OLIMEX/ESP32-PRO/README.md

# ESP32-PRO
Open-source hardware ESP32 IoT board with 4MB external RAM, 4MB external flash, LiPo charger, USB-OTG, external crypto engine option. The board uses PIC32 as USB-serial converter. 

Product page:

https://www.olimex.com/Products/IoT/ESP32/ESP32-PRO/open-source-hardware
