OLIMEX/ESP32-PRO/SOFTWARE/ESP32_part_Arduino_IDE/ESP32_Demo/README.txt

This example works with Espressif package 1.0.0v. With 1.0.1v compiling fails.
