OLIMEX/ESP32-PRO/HARDWARE/REV-B1/3d/usb_micro_4p.stp

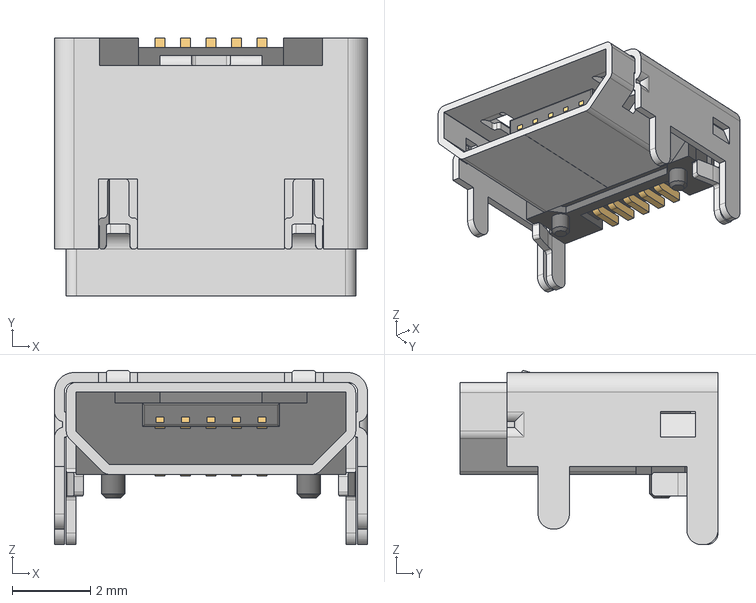
[picture p1: CAD file, 2020-09-01]
HARDWARE/REV-B1/3d/usb_micro_4p.stp
8.00 x 6.60 x 4.46 mm
