OLIMEX/ESP32-PRO/HARDWARE/REV-B1/3d/L-CD32_shielded.step

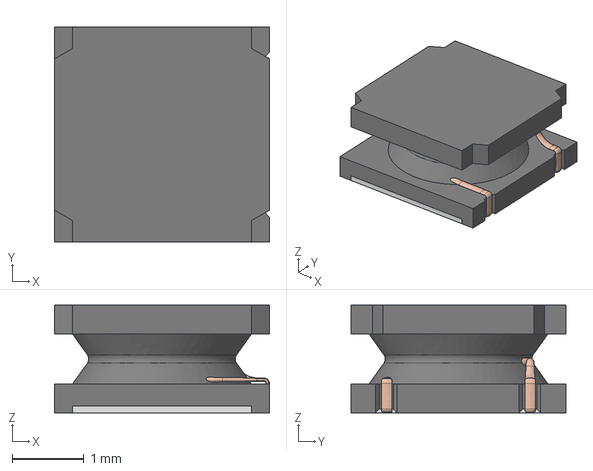
[picture p2: CAD file, 2020-09-01]
HARDWARE/REV-B1/3d/L-CD32_shielded.step
3.00 x 3.00 x 1.50 mm
