OLIMEX/ESP32-PRO/HARDWARE/REV-B1/3d/MSOP10-1.step

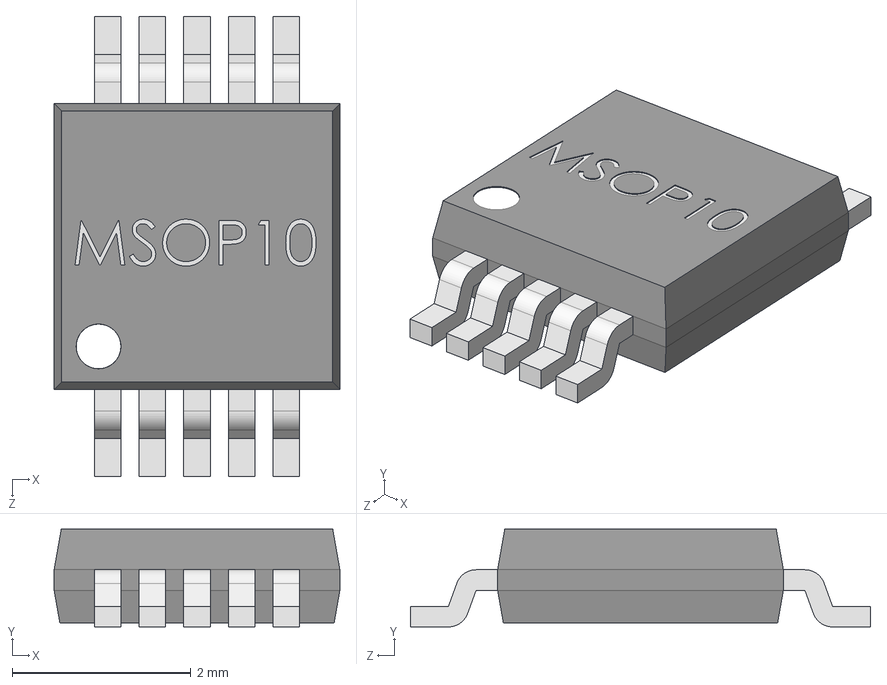
[picture p3: CAD file, 2020-09-01]
HARDWARE/REV-B1/3d/MSOP10-1.step
3.20 x 1.10 x 5.15 mm
