OLIMEX/ESP32-PRO/HARDWARE/REV-B1/3d/TQFP-44-10x10x1mm_Step-0.80mm.STEP

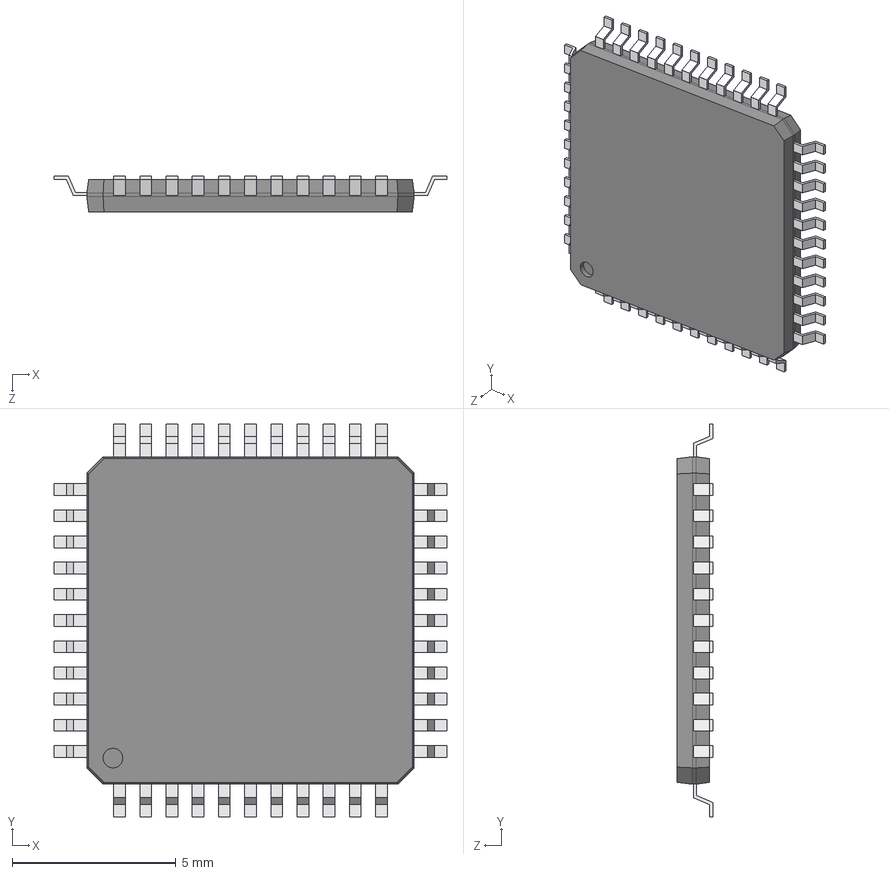
[picture p4: CAD file, 2020-09-01]
HARDWARE/REV-B1/3d/TQFP-44-10x10x1mm_Step-0.80mm.STEP
12.0 x 12.0 x 1.10 mm
pin001
pin021
pin022
pin020
pin019
pin018
pin017
pin024
pin023
pin007
pin003
pin015
pin014
pin013
pin012
pin011
pin010
pin009
pin008
pin006
pin005
pin004
pin002
pin016
pin027
pin037
pin025
pin026
pin036
pin035
pin034
pin033
pin032
pin031
pin030
pin029
pin028
pin038
pin044
pin043
pin042
pin041
pin040
pin039
