OLIMEX/ESP32-PRO/HARDWARE/REV-B1/3d/microSD.step

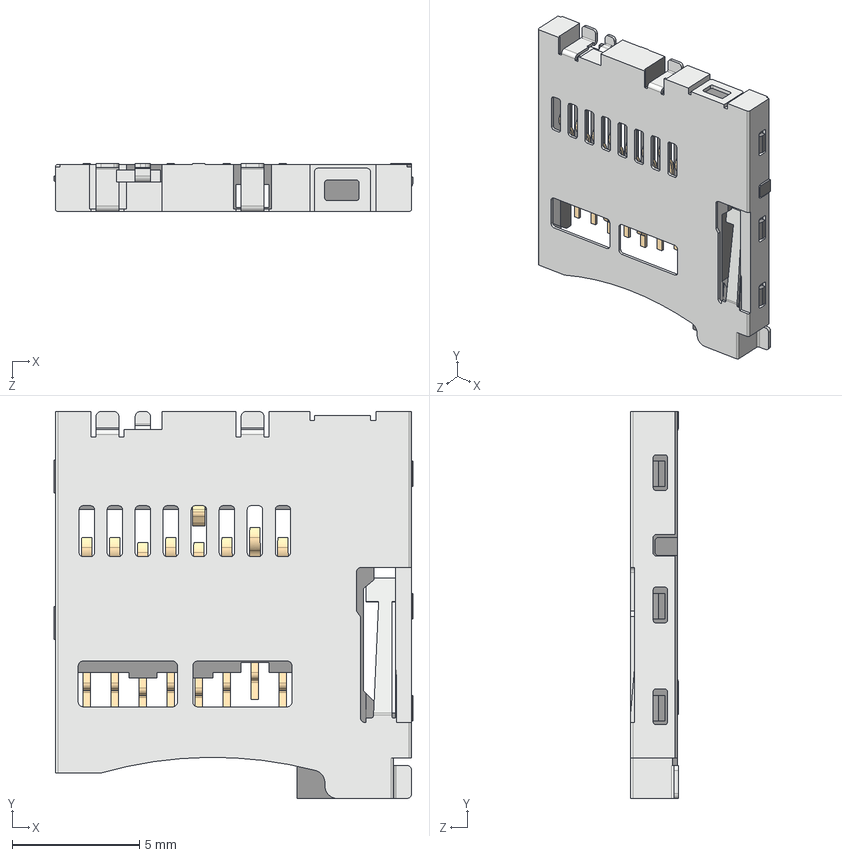
[picture p5: CAD file, 2020-09-01]
HARDWARE/REV-B1/3d/microSD.step
14.1 x 15.2 x 1.88 mm
