OLIMEX/ESP32-PRO/HARDWARE/REV-B1/3d/SO-8_208mil---SOIC8_Wide_5mmx5mm.step

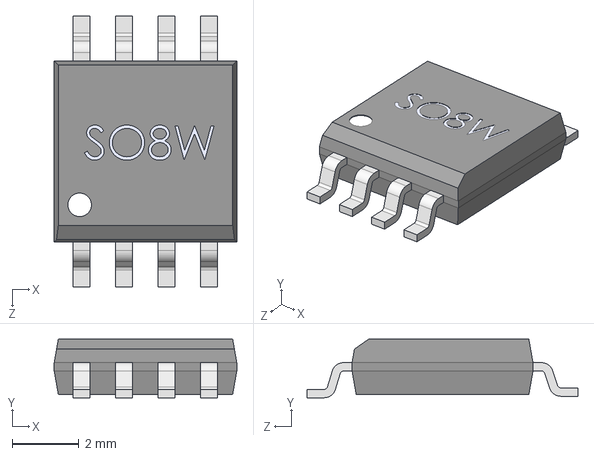
[picture p6: CAD file, 2020-09-01]
HARDWARE/REV-B1/3d/SO-8_208mil---SOIC8_Wide_5mmx5mm.step
5.46 x 1.75 x 8.10 mm
