OLIMEX/ESP32-PRO/HARDWARE/REV-B1/3d/QSG5032.step

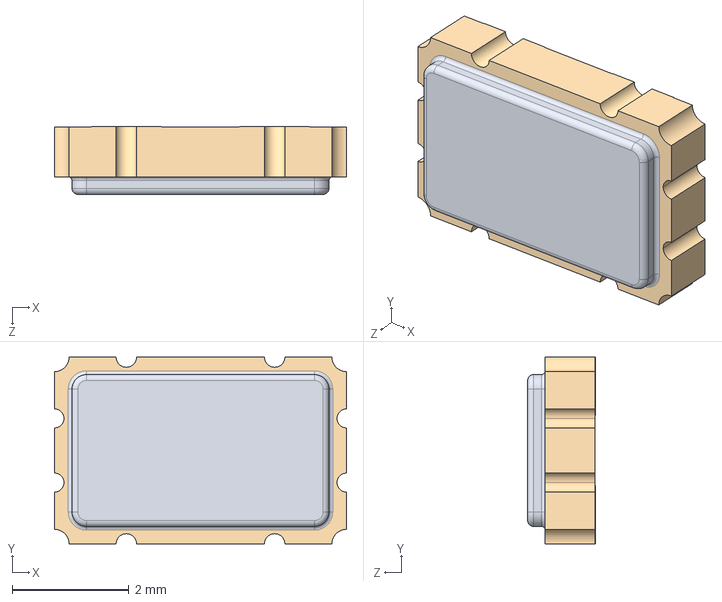
[picture p7: CAD file, 2020-09-01]
HARDWARE/REV-B1/3d/QSG5032.step
5.00 x 3.20 x 1.16 mm
