OLIMEX/ESP32-PRO/HARDWARE/REV-B1/3d/mc-306crystal.step

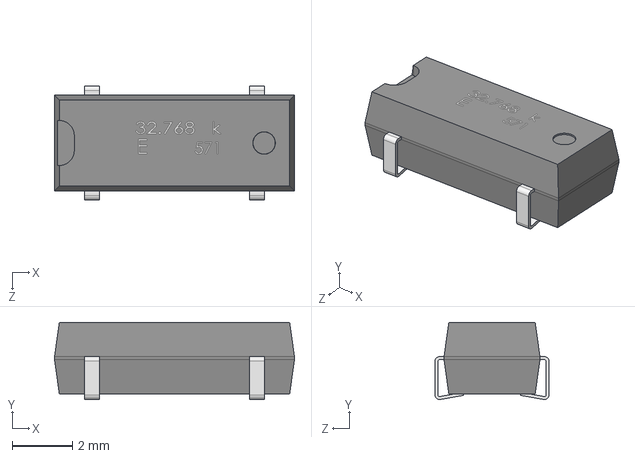
[picture p8: CAD file, 2020-09-01]
HARDWARE/REV-B1/3d/mc-306crystal.step
8.00 x 2.57 x 3.80 mm
