OLIMEX/ESP32-PRO/HARDWARE/REV-B1/3d/BAT54.step

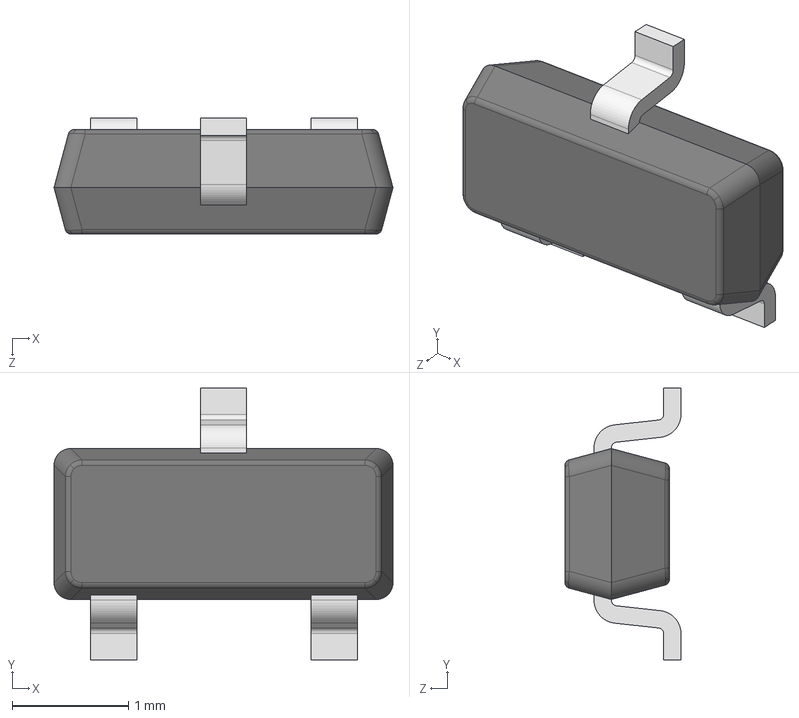
[picture p9: CAD file, 2020-09-01]
HARDWARE/REV-B1/3d/BAT54.step
2.92 x 2.34 x 1.00 mm
