OLIMEX/ESP32-PRO/HARDWARE/REV-B1/3d/Micro_SD_card.step

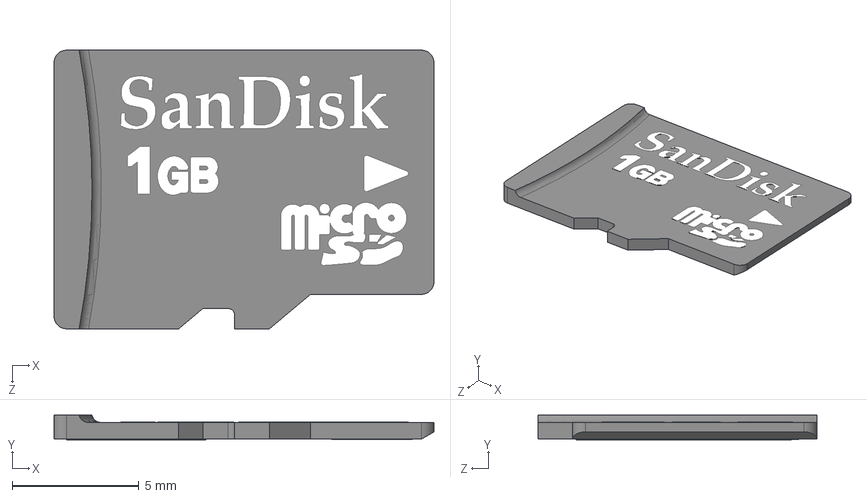
[picture p10: CAD file, 2020-09-01]
HARDWARE/REV-B1/3d/Micro_SD_card.step
15.0 x 0.975 x 11.0 mm
