OLIMEX/ESP32-PRO/HARDWARE/REV-B1/3d/SOT-23.step

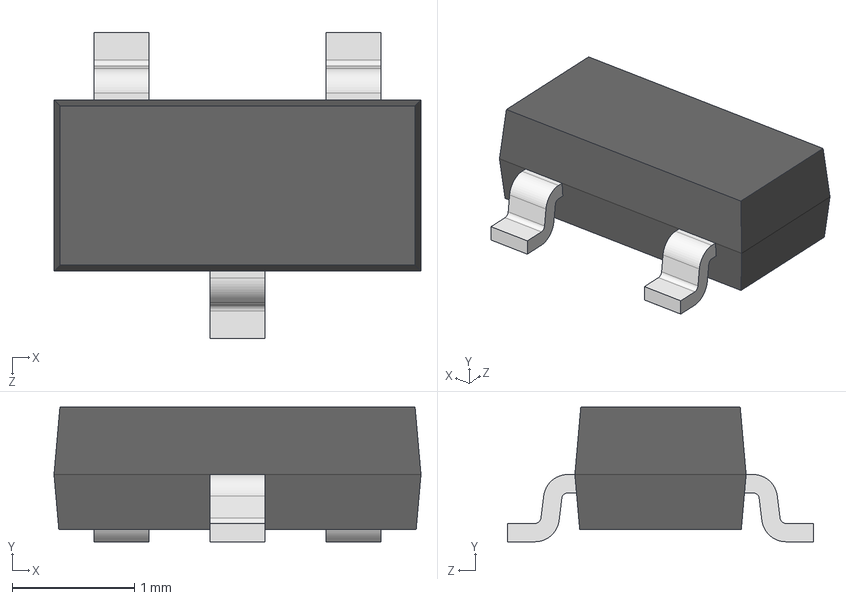
[picture p12: CAD file, 2020-09-01]
HARDWARE/REV-B1/3d/SOT-23.step
3.00 x 1.10 x 2.50 mm
