OLIMEX/ESP32-PRO/HARDWARE/REV-B1/3d/SMD5032.STEP

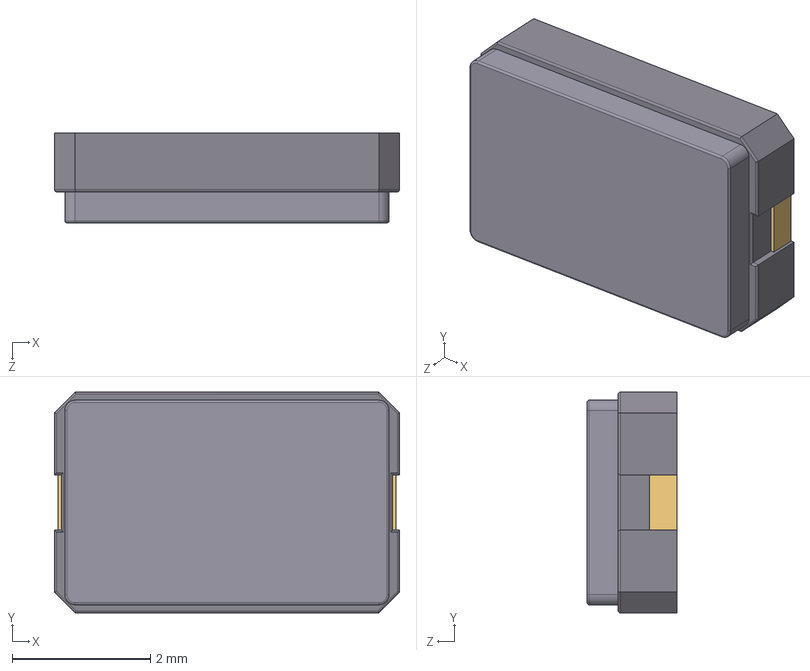
[picture p13: CAD file, 2020-09-01]
HARDWARE/REV-B1/3d/SMD5032.STEP
5.00 x 3.20 x 1.30 mm
User Library-ABM3-1_Fillet002
User Library-ABM3-1_Fillet001
User Library-ABM3-1_Pad001
