OLIMEX/ESP32-PRO/HARDWARE/REV-B1/3d/DO-214AA_SMB.step

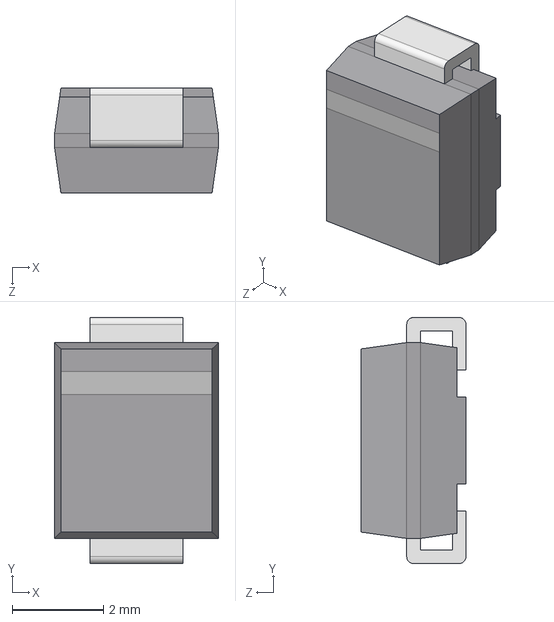
[picture p14: CAD file, 2020-09-01]
HARDWARE/REV-B1/3d/DO-214AA_SMB.step
3.60 x 5.40 x 2.30 mm
