OLIMEX/ESP32-PRO/HARDWARE/REV-B1/3d/JST_B2B-PH-SM4-TB(DW02R).step

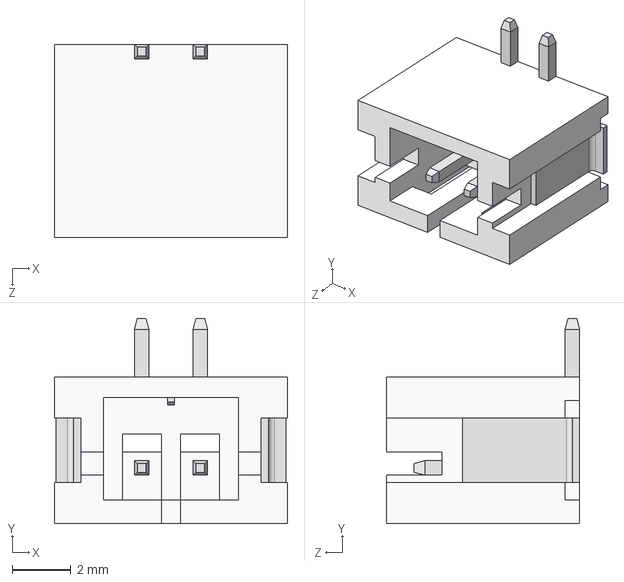
[picture p15: CAD file, 2020-09-01]
HARDWARE/REV-B1/3d/JST_B2B-PH-SM4-TB(DW02R).step
7.95 x 7.00 x 6.60 mm
