OLIMEX/ESP32-PRO/HARDWARE/REV-B1/3d/SO-8_150mil---SN65HVDA1050AQDRQ1.STEP

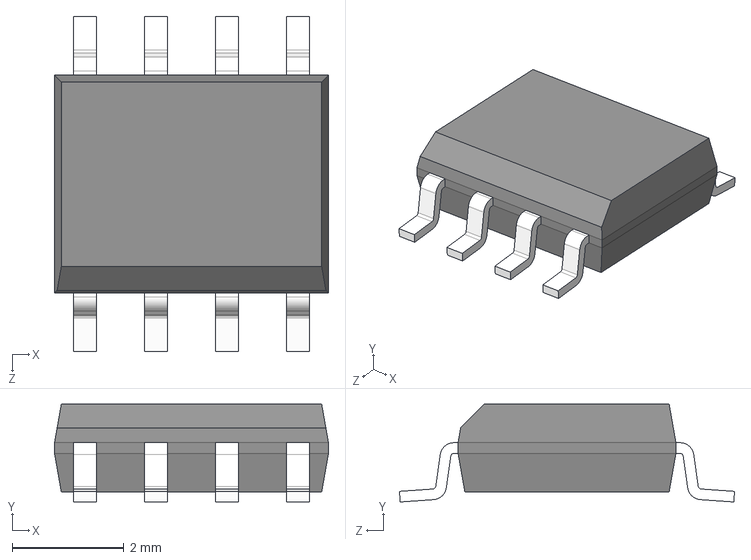
[picture p16: CAD file, 2020-09-01]
HARDWARE/REV-B1/3d/SO-8_150mil---SN65HVDA1050AQDRQ1.STEP
4.90 x 1.75 x 5.99 mm
