OLIMEX/ESP32-PRO/HARDWARE/REV-B1/3d/DO-214AC_SMA.step

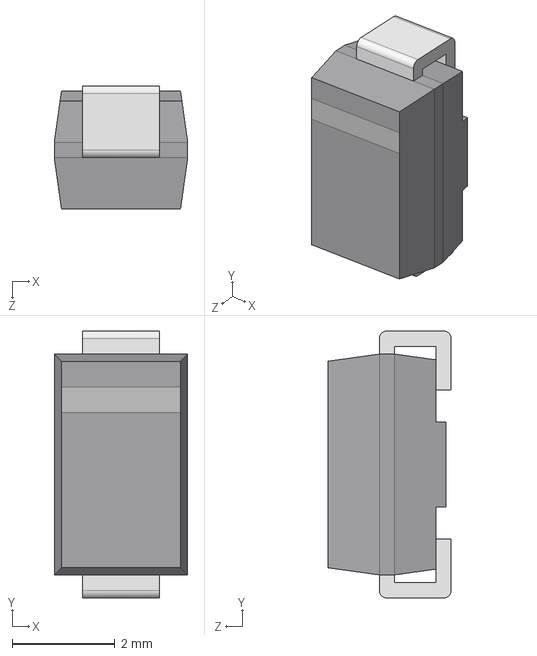
[picture p17: CAD file, 2020-09-01]
HARDWARE/REV-B1/3d/DO-214AC_SMA.step
2.60 x 5.20 x 2.40 mm
