OLIMEX/ESP32-PRO/HARDWARE/REV-B1/3d/QFN-48_6x6mm_Pitch-0.4mm.STEP

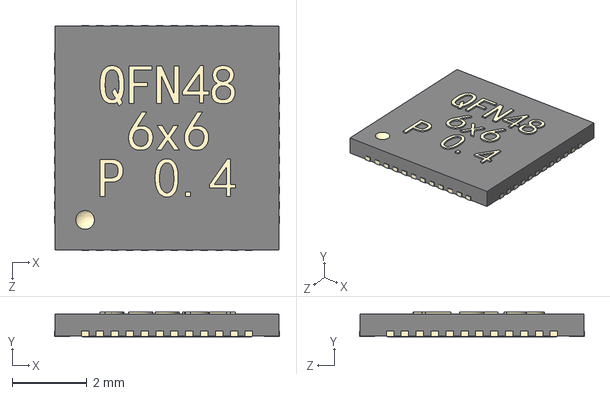
[picture p18: CAD file, 2020-09-01]
HARDWARE/REV-B1/3d/QFN-48_6x6mm_Pitch-0.4mm.STEP
6.04 x 0.67 x 6.04 mm
