OLIMEX/ESP32-PRO/(list of files, cad)

Other CAD files:
HARDWARE/REV-B1/3d/434121043836 (rev1).stp
