OLIMEX/ESP32-PRO/HARDWARE/REV-B1/ESP32-PRO_Rev_B1-BOM.pdf

# ESP32-PRO_Rev_B1 30.07.2018

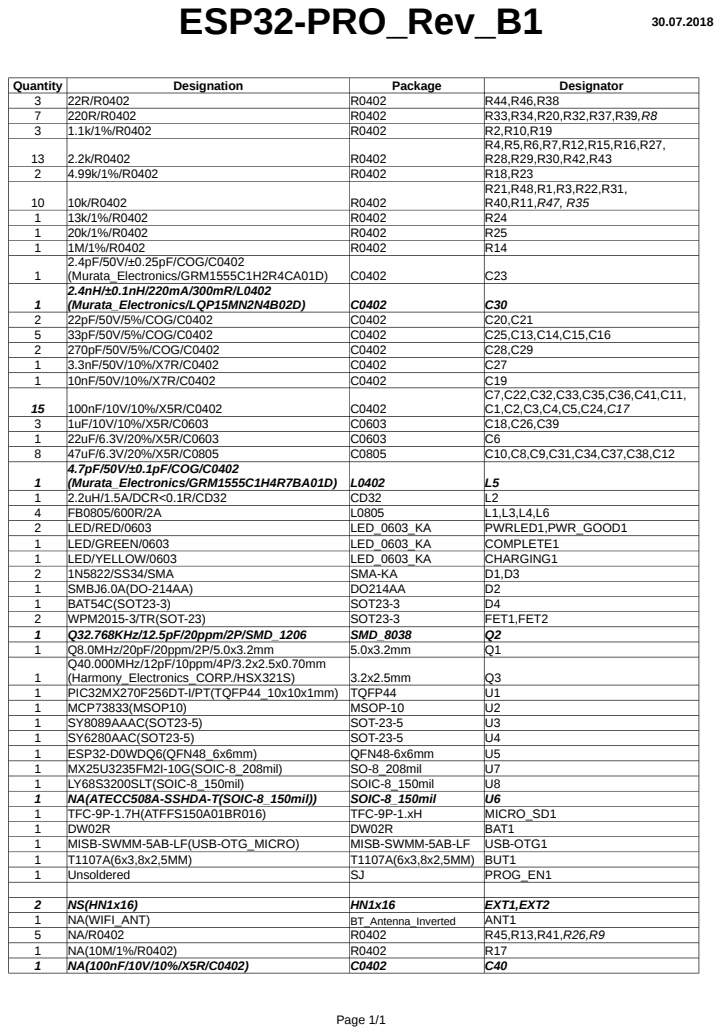
[picture p19: page 1]
