OLIMEX/ESP32-PRO/HARDWARE/REV-B1/ESP32-PRO_Rev_B1.pdf

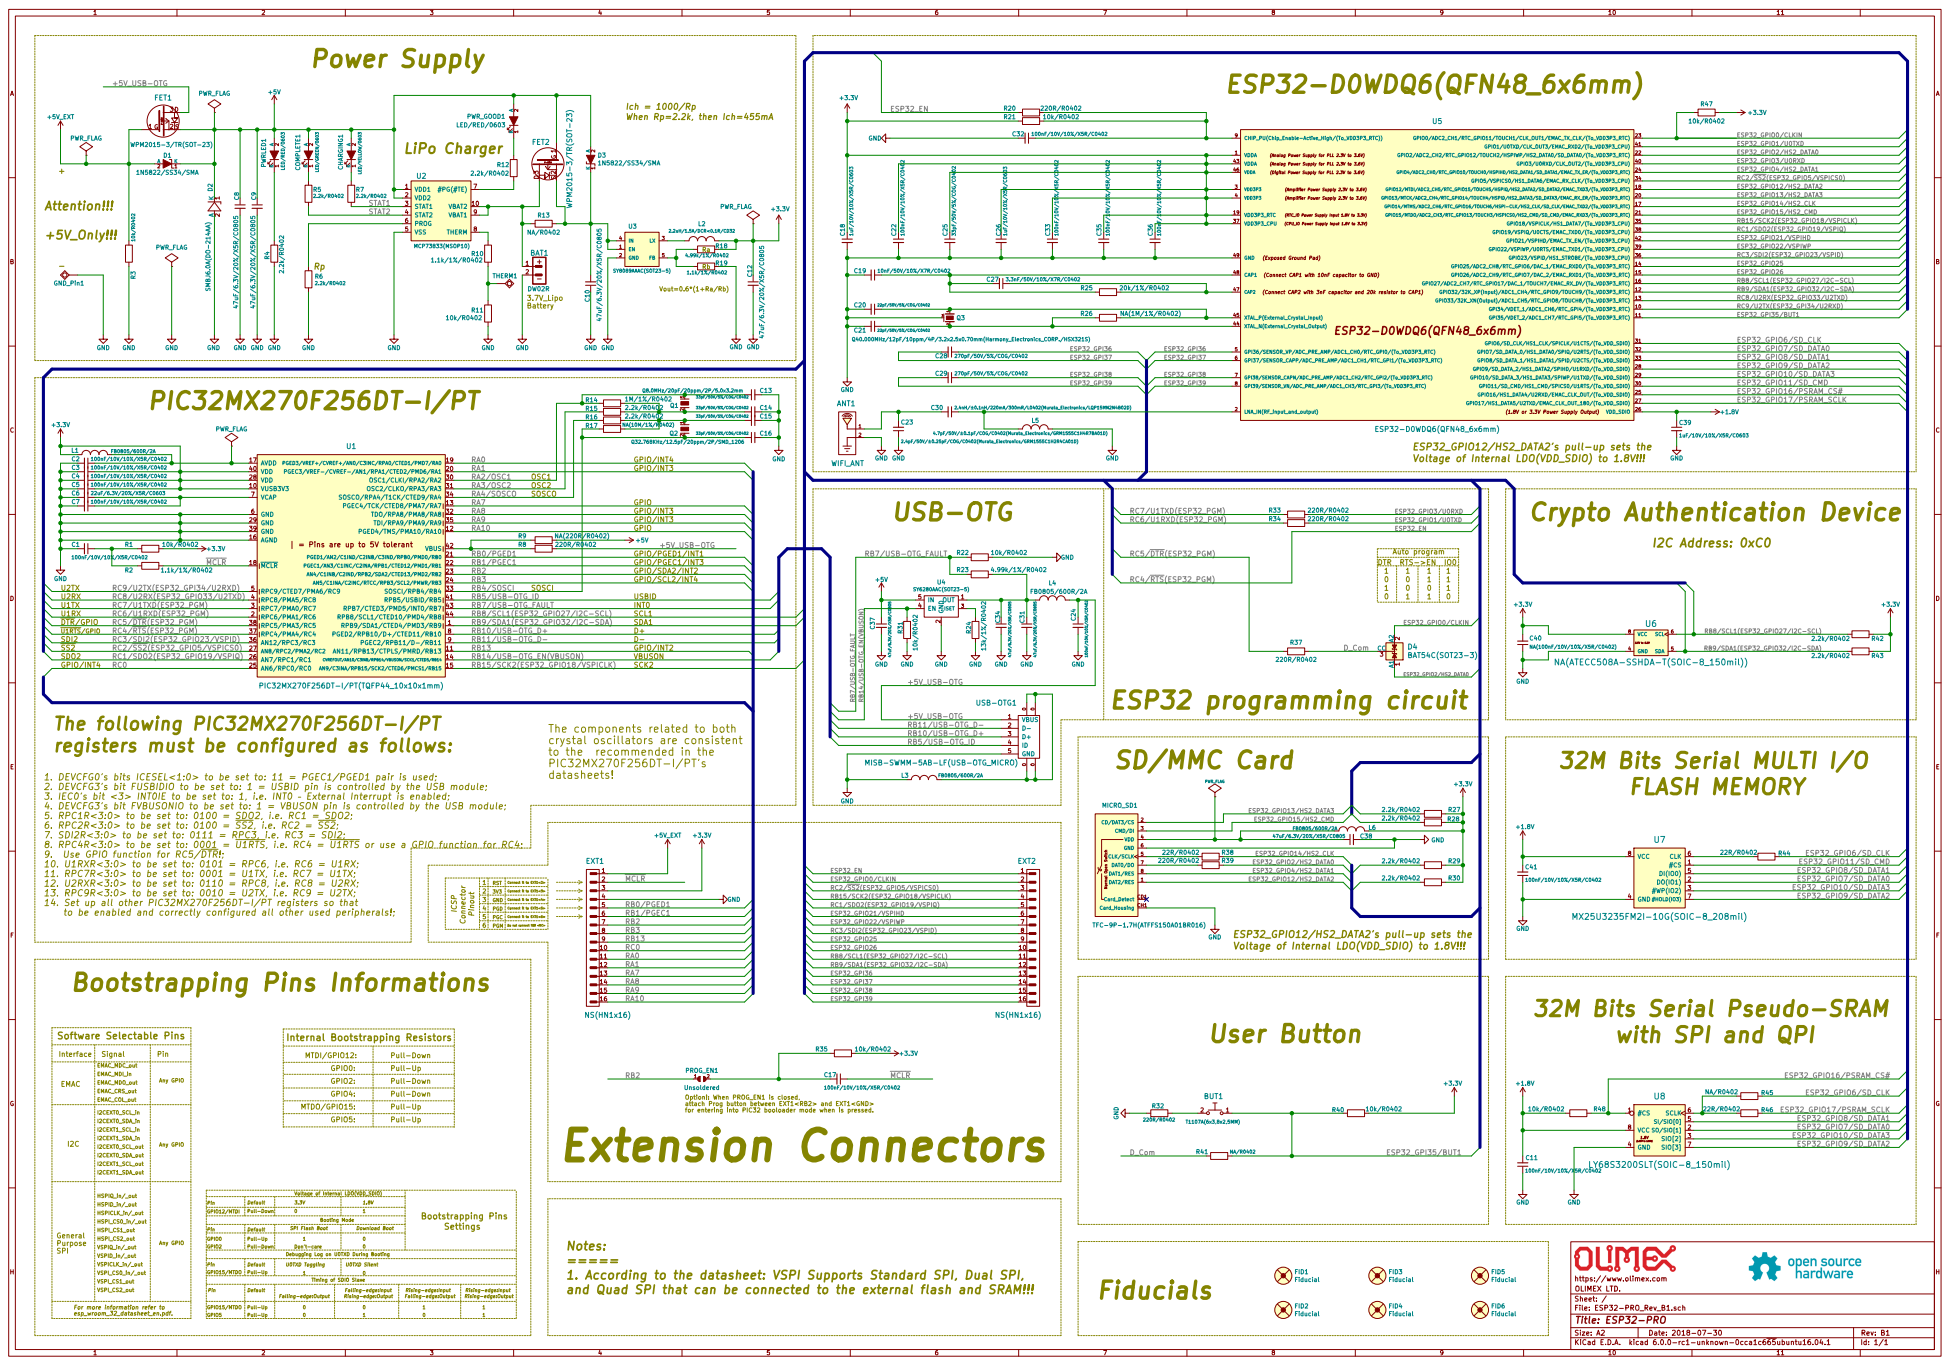
[picture p20: page 1]

2 PWRLED1 LED/RED/0603 GND GND GND GND

(Analog Power Supply for PLL 2.3V to 3.6V) (Connect CAP1 with 10nF capacitor to GND)
(Analog Power Supply for PLL 2.3V to 3.6V)
(CPU_IO Power Supply Input 1.8V to 3.3V) (Digital Power Supply for PLL 2.3V to 3.6V) (Exposed Ground Pad)

(Amplifier Power Supply 2.3V to 3.6V)

(RTC_IO Power Supply Input 1.8V to 3.3V) ESP32-D0WDQ6(QFN48_6x6mm)

(Connect CAP2 with 3nF capacitor and 20k resistor to CAP1)

I2C Address: 0xC0 32M Bits Serial Pseudo-SRAM

RC5/DTR(ESP32_PGM) RB11/USB-OTG_D- RB10/USB-OTG_D+ RB11/USB-OTG_D- RB10/USB-OTG_D+

registers must be configured as follows:

crystal oscillators are consistent

1. DEVCFG0's bits ICESEL<1:0> to be set to: 11 = PGEC1/PGED1 pair is used; 2. DEVCFG3's bit FUSBIDIO to be set to: 1 = USBID pin is controlled by the USB module; 3. IEC0's bit <3> INT0IE to be set to: 1, i.e. INT0 External Interrupt is enabled; 4. DEVCFG3's bit FVBUSONIO to be set to: 1 = VBUSON pin is controlled by the USB module; 5. RPC1R<3:0> to be set to: 0100 = SDO2, i.e. RC1 = SDO2; 6. RPC2R<3:0> to be set to: 0100 = SS2, i.e. RC2 = SS2; 7. SDI2R<3:0> to be set to: 0111 = RPC3, i.e. RC3 = SDI2; 8. RPC4R<3:0> to be set to: 0001 = U1RTS, i.e. RC4 = U1RTS or use a GPIO function for RC4; 9. Use GPIO function for RC5/DTR!; 10. U1RXR<3:0> to be set to: 0101 = RPC6, i.e. RC6 = U1RX; 11. RPC7R<3:0> to be set to: 0001 = U1TX, i.e. RC7 = U1TX; 12. U2RXR<3:0> to be set to: 0110 = RPC8, i.e. RC8 = U2RX; 13. RPC9R<3:0> to be set to: 0010 = U2TX, i.e. RC9 = U2TX; 14. Set up all other PIC32MX270F256DT-I/PT registers so that

Connect it to EXT1<2> Connect it to EXT1<3> Connect it to EXT1<4> Connect it to EXT1<5> Connect it to EXT1<6> Do not connect it!!! <NC> 1
3V3 GND
PGD
PGC
PGM

to be enabled and correctly configured all other used peripherals!;

with SPI and QPI

Option!: When PROG_EN1 is closed, attach Prog button between EXT1<RB2> and EXT1<GND>
for entering into PIC32 booloader mode when is pressed.

File: ESP32-PRO_Rev_B1.sch Sheet: / OLIMEX LTD. https://www.olimex.com
