OLIMEX/ESP32-PRO/HARDWARE/REV-B/ESP32-PRO_Rev_B-BOM.pdf

# ESP32-PRO_Rev_B 10.01.2018

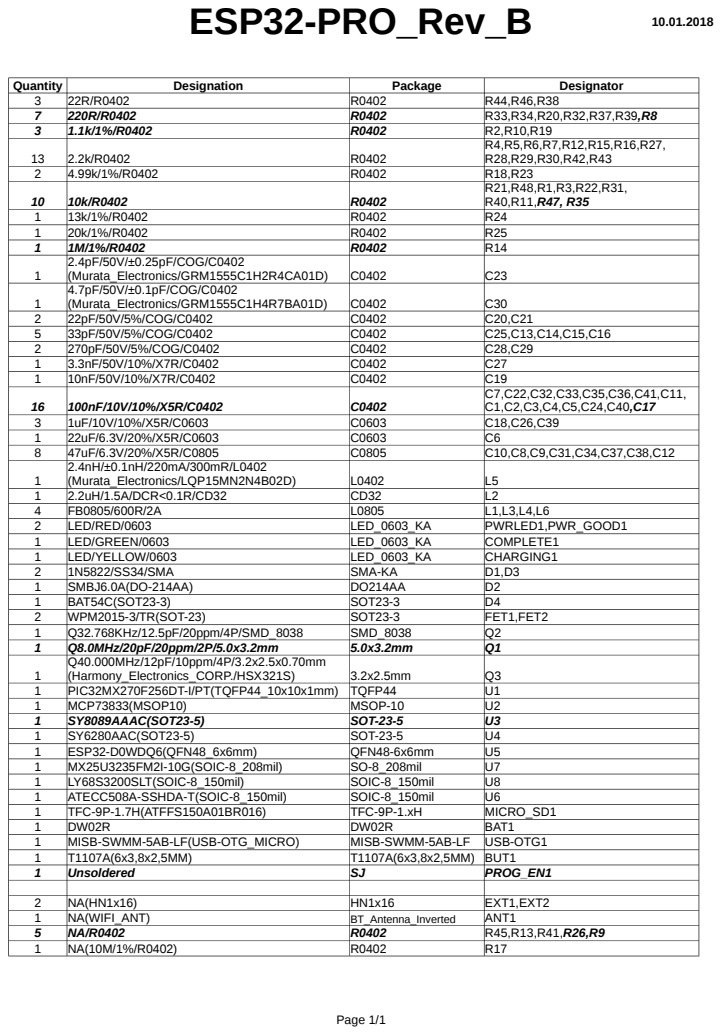
[picture p21: page 1]
