OLIMEX/ESP32-PRO/HARDWARE/REV-A/ESP32-PRO_Rev_A.pdf

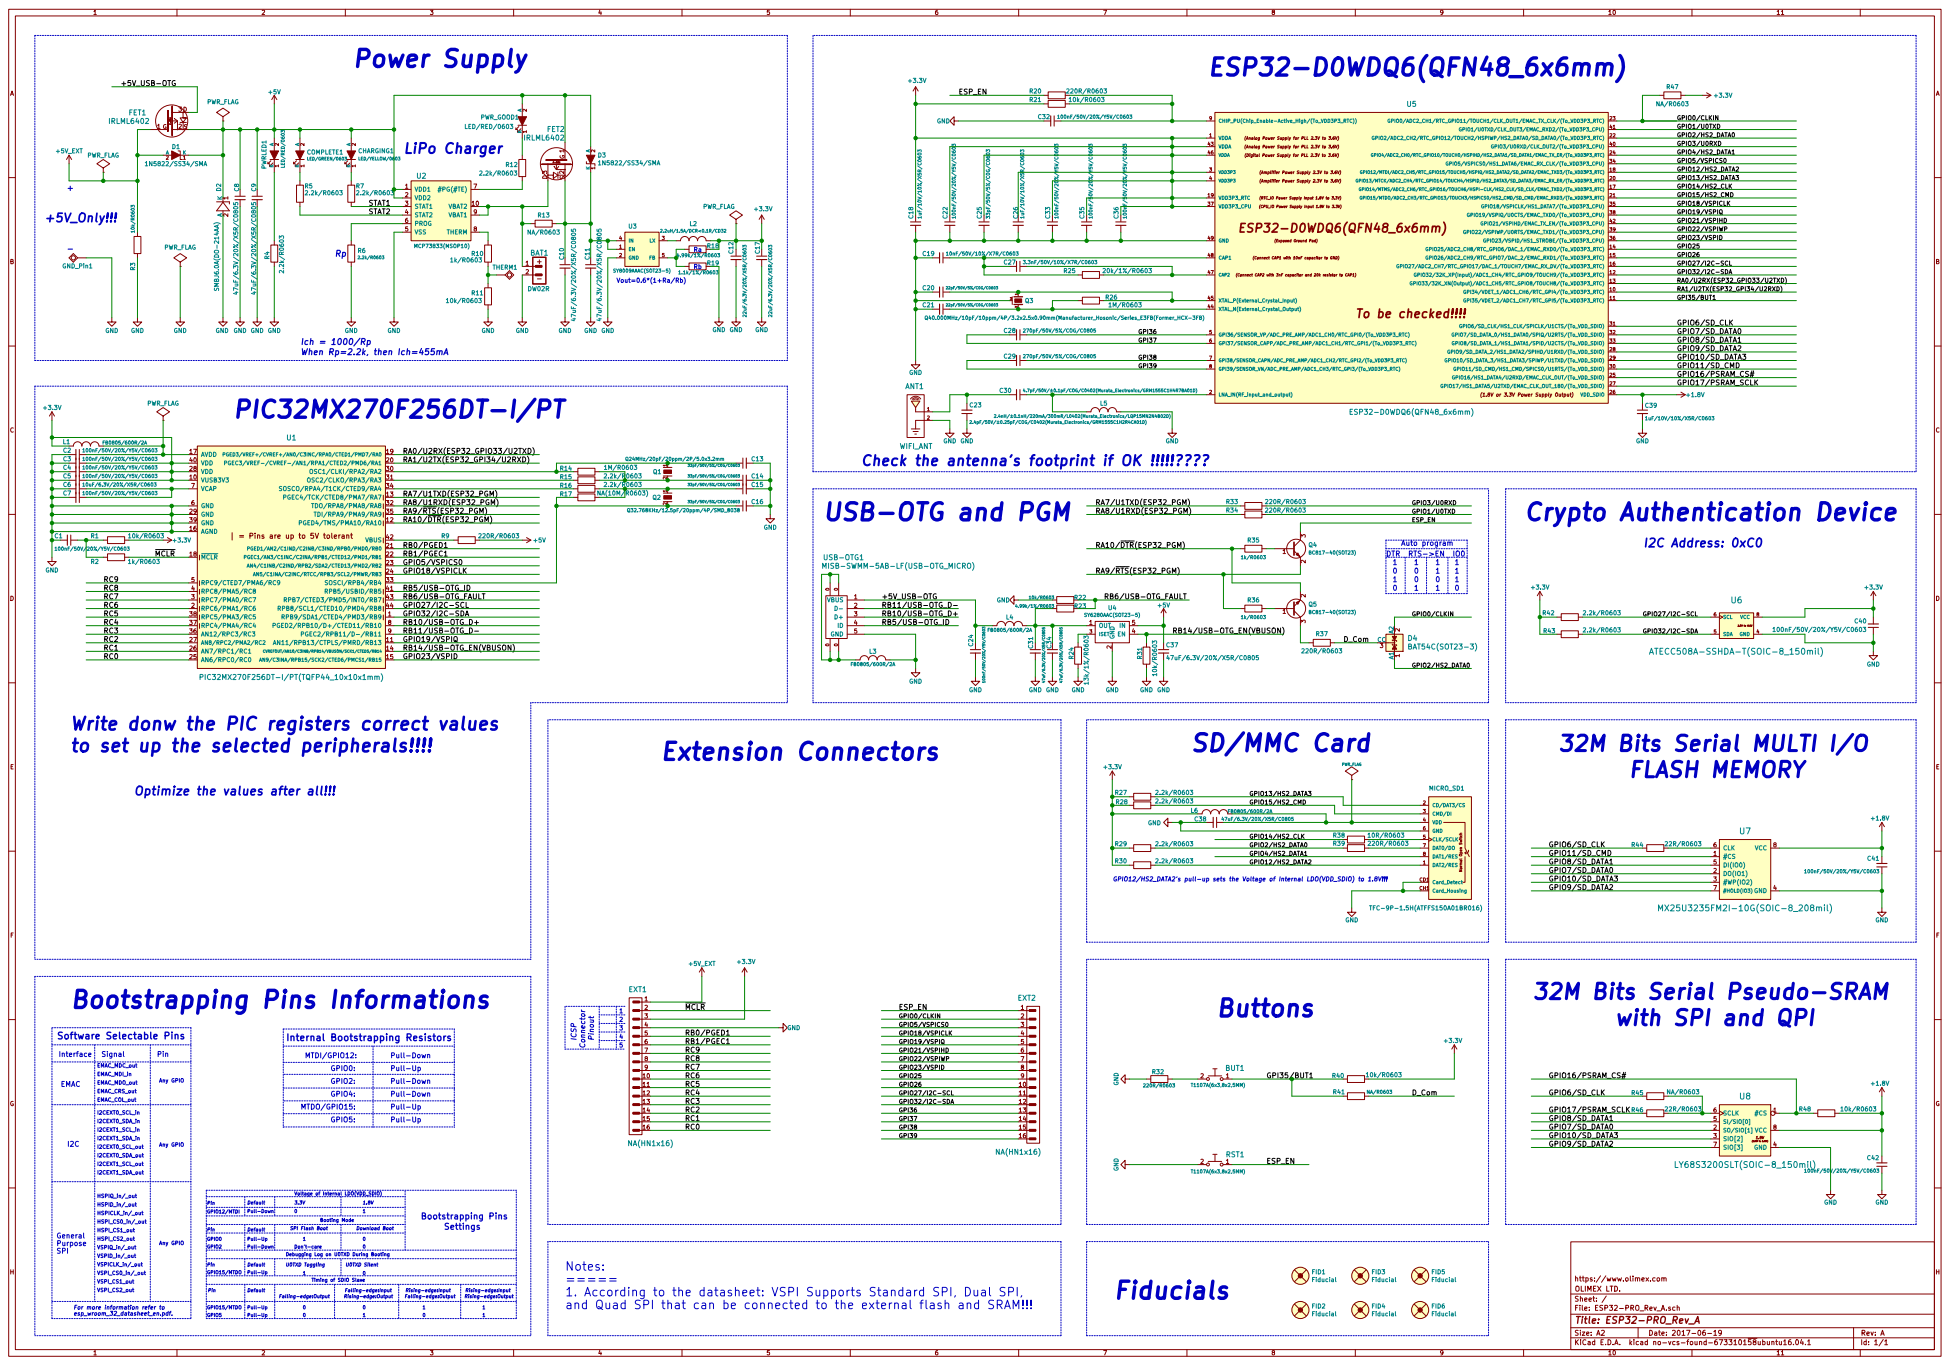
[picture p22: page 1]

2 PWRLED1 LED/RED/0603 GND GND GND GND GND

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

(Amplifier Power Supply 2.3V to 3.6V)

(RTC_IO Power Supply Input 1.8V to 3.3V) ESP32-D0WDQ6(QFN48_6x6mm)

(Connect CAP1 with 10nF capacitor to GND)

(Connect CAP2 with 3nF capacitor and 20k resistor to CAP1)

(1.8V or 3.3V Power Supply Output)

MISB-SWMM-5AB-LF(USB-OTG_MICRO) GND

Write donw the PIC registers correct values
to set up the selected peripherals!!!!

Optimize the values after all!!!

32M Bits Serial Pseudo-SRAM
with SPI and QPI

16 EXT2 NA(HN1x16)
GPIO22/VSPIWP GPIO21/VSPIHD GPIO18/VSPICLK GPIO27/I2C-SCL GPIO23/VSPID GPIO32/I2C-SDA GPIO25 GPIO26 GPI39 GPI36 GPI37 GPI38

Notes: =====
1. According to the datasheet: VSPI Supports Standard SPI, Dual SPI,
and Quad SPI that can be connected to the external flash and SRAM!!!

File: ESP32-PRO_Rev_A.sch Sheet: / OLIMEX LTD. https://www.olimex.com
