OLIMEX/ESP32-PRO/HARDWARE/REV-B1/ESP32-PRO_Rev_B1.kicad_pcb

## KiCad design HARDWARE/REV-B1/ESP32-PRO_Rev_B1.kicad_pcb (2020-09-01)

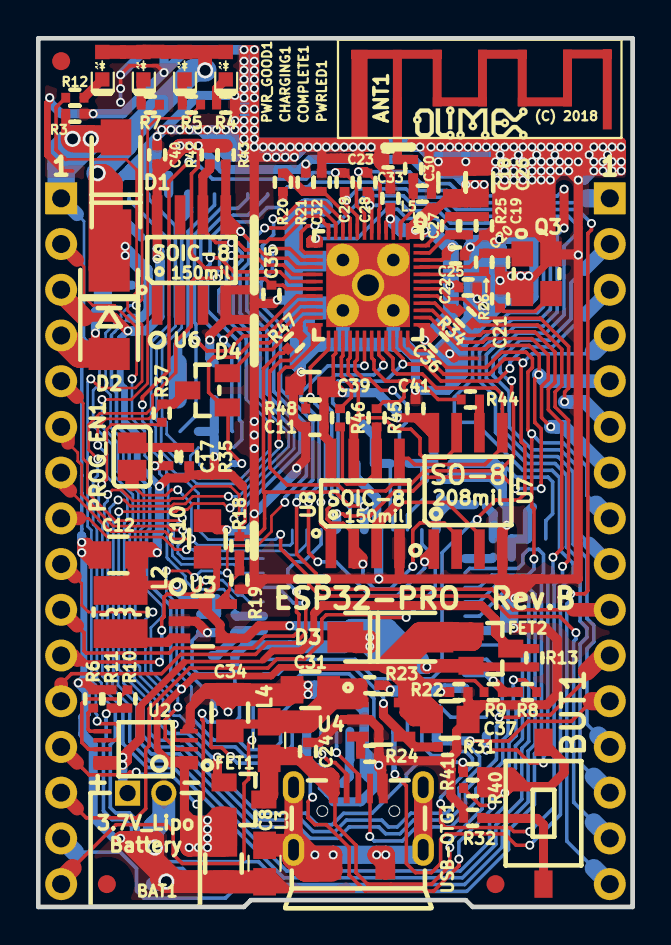
[picture p23: board ESP32-PRO_Rev_B1.kicad_pcb from above]

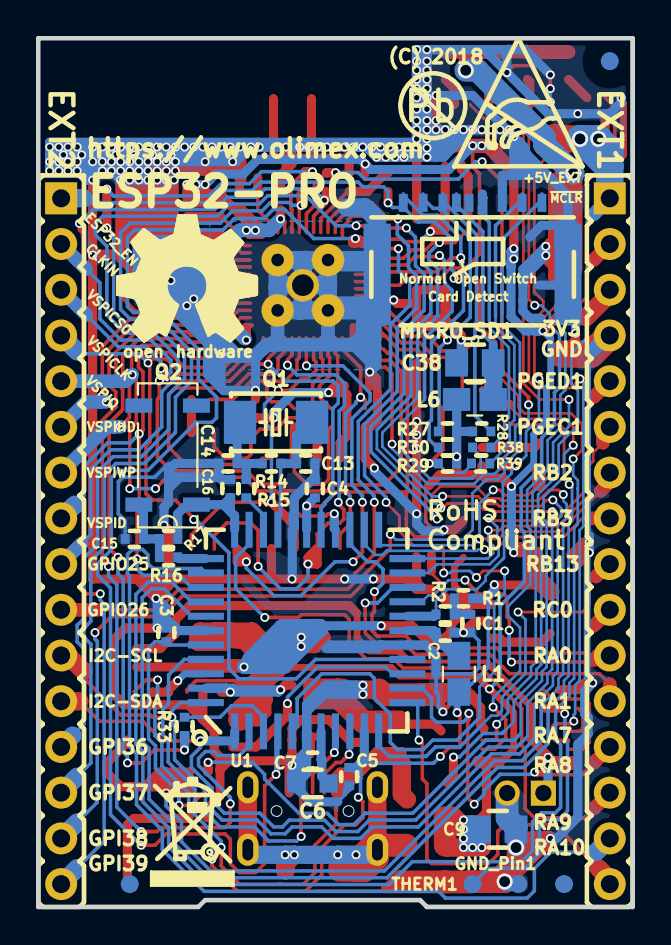
[picture p24: board ESP32-PRO_Rev_B1.kicad_pcb from below]

Board: 2 copper layers, 33.0 x 48.3 mm, 132 parts (40 on the bottom side), 104 nets.

Parts:
ANT1: WIFI_ANT; BT_Antenna_Inverted_1ANT_2GND
BAT1: DW02R; LIPO_BAT-CON2DW02R
BUT1: T1107A(6x3,8x2,5MM)
C1, C2, C3, C4, C5, C7, C11, C17, C22, C24, C32, C33, C35, C36, C41: 100nF/10V/10%/X5R/C0402; C_0402_5MIL_DWS
C6: 22uF/6.3V/20%/X5R/C0603; C_0603_5MIL_DWS
C8, C9, C10, C12, C31, C34, C37, C38: 47uF/6.3V/20%/X5R/C0805; C_0805_5MIL_DWS
C13, C14, C15, C16, C25: 33pF/50V/5%/COG/C0402; C_0402_5MIL_DWS
C18, C26, C39: 1uF/10V/10%/X5R/C0603; C_0603_5MIL_DWS
C19: 10nF/50V/10%/X7R/C0402; C_0402_5MIL_DWS
C20, C21: 22pF/50V/5%/COG/C0402; C_0402_5MIL_DWS
C23: 2.4pF/50V/±0.25pF/COG/C0402(Murata_Electronics/GR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; C_0402_5MIL_DWS
C27: 3.3nF/50V/10%/X7R/C0402; C_0402_5MIL_DWS
C28, C29: 270pF/50V/5%/COG/C0402; C_0402_5MIL_DWS
C30: 2.4nH/±0.1nH/220mA/300mR/L0402(Murata_Electronics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; C_0402_5MIL_DWS
C40: NA(100nF/10V/10%/X5R/C0402); C_0402_5MIL_DWS
CHARGING1: LED/YELLOW/0603; LED_0603_KA
COMPLETE1: LED/GREEN/0603; LED_0603_KA
D1, D3: 1N5822/SS34/SMA; SMA-KA
D2: SMBJ6.0A(DO-214AA); DO214AA_1(K)-2(A)
D4: BAT54C(SOT23-3); SOT23-3
EXT1, EXT2: NS(HN1x16); HN1x16
FET1, FET2: WPM2015-3/TR(SOT-23); SOT23
FID1, FID2, FID3, FID4, FID5, FID6: Fiducial; Fiducial1x3
GND_Pin1: TESTPAD; TESTPAD_40-ROUND
L1, L3, L4, L6: FB0805/600R/2A; L_0805_5MIL_DWS
L2: 2.2uH/1.5A/DCR<0.1R/CD32; CD32
L5: 4.7pF/50V/±0.1pF/COG/C0402(Murata_Electronics/GRM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; L_0402_5MIL_DWS
MICRO_SD1: TFC-9P-1.7H(ATFFS150A01BR016); uSD(TFC-9P-1.xH(ATFFS150A01BR016))
PROG_EN1: Unsoldered; SJ
PWRLED1: LED/RED/0603; LED_0603_KA
PWR_GOOD1: LED/RED/0603; LED_0603_KA
Q1: Q8.0MHz/20pF/20ppm/2P/5.0x3.2mm; HCX-4S_2Pins_5.0x3.2mm
Q2: Q32.768KHz/12.5pF/20ppm/2P/SMD_1206; MC306-HS
Q3: Q40.000MHz/12pF/10ppm/4P/3.2x2.5x0.70mm(Harmony_E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; TSX-3.2x2.5mm_GND(3)
R1, R3, R11, R21, R22, R31, R35, R40, R47, R48: 10k/R0402; R_0402_5MIL_DWS
R2, R10, R19: 1.1k/1%/R0402; R_0402_5MIL_DWS
R4, R5, R6, R7, R12, R15, R16, R27, R28, R29, R30, R42, R43: 2.2k/R0402; R_0402_5MIL_DWS
R8, R20, R32, R33, R34, R37, R39: 220R/R0402; R_0402_5MIL_DWS
R9: NA(220R/R0402); R_0402_5MIL_DWS
R13, R41, R45: NA/R0402; R_0402_5MIL_DWS
R14: 1M/1%/R0402; R_0402_5MIL_DWS
R17: NA(10M/1%/R0402); R_0402_5MIL_DWS
R18, R23: 4.99k/1%/R0402; R_0402_5MIL_DWS
R24: 13k/1%/R0402; R_0402_5MIL_DWS
R25: 20k/1%/R0402; R_0402_5MIL_DWS
R26: NA(1M/1%/R0402); R_0402_5MIL_DWS
R38, R44, R46: 22R/R0402; R_0402_5MIL_DWS
Ref**: Val**; LOGO_ANTISTATIC_1
THERM1: TESTPAD; TESTPAD_40-ROUND
U1: PIC32MX270F256DT-I/PT(TQFP44_10x10x1mm); TQFP44
U2: MCP73833(MSOP10); MSOP-10_Pitch-0.5mm_3.00x3.00x1.00mm
U3: SY8089AAAC(SOT23-5); SOT-23-5
U4: SY6280AAC(SOT23-5); SOT-23-5
U5: ESP32-D0WDQ6(QFN48_6x6mm); QFN48-6x6mm-OLIMEX_V2
U6: NA(ATECC508A-SSHDA-T(SOIC-8_150mil)); SOIC-8_150mil
U7: MX25U3235FM2I-10G(SOIC-8_208mil); SO-8_208mil
U8: LY68S3200SLT(SOIC-8_150mil); SOIC-8_150mil
USB-OTG1: MISB-SWMM-5AB-LF(USB-OTG_MICRO); USB-MICRO_MISB-SWMM-5B_LF

Connections:
+1V8: C11.2, C39.1, C41.2, R48.2, U5.26, U7.8, U8.8
+3V3: C3.1, C4.1, C5.1, C12.1, C18.1, C22.1, C25.1, C26.1, C33.1, C35.1, C36.1, C40.2, EXT1.3, L1.1, L2.2, L6.1, R1.2, R18.2, R21.1, R27.1, R28.1, R29.1, R30.1, R35.2, R40.2, R42.1, R43.1, R47.2, U1.10, U1.28, U1.40, U5.1, U5.3, U5.4, U5.19, U5.37, U5.43, U5.46, U6.8
+5V: C8.1, C9.1, C37.1, CHARGING1.2, COMPLETE1.2, D1.1, D2.1, D3.2, FET1.2, FET2.1, PWRLED1.2, PWR_GOOD1.2, R9.2, U2.1, U2.2, U4.5
+5V_EXT: D1.2, EXT1.1, FET1.1, R3.1
/+5V_USB-OTG: C24.1, FET1.3, L4.1, R8.2, USB-OTG1.1
/D_Com: D4.3, R37.2, R41.1
/ESP32_EN: EXT2.1, R20.1, U1.37
/ESP32_GPI35/BUT1: BUT1.1, R40.1, R41.2, U5.11
/ESP32_GPI36: C28.1, EXT2.13, U5.5
/ESP32_GPI37: C28.2, EXT2.14, U5.6
/ESP32_GPI38: C29.1, EXT2.15, U5.7
/ESP32_GPI39: C29.2, EXT2.16, U5.8
/ESP32_GPIO0/CLKIN: D4.2, EXT2.2, R47.1, U5.23
/ESP32_GPIO1/U0TXD: R34.2, U5.41
/ESP32_GPIO2/HS2_DATA0: D4.1, R29.2, R39.1, U5.22
/ESP32_GPIO3/U0RXD: R33.2, U5.40
/ESP32_GPIO4/HS2_DATA1: MICRO_SD1.8, U5.24
/ESP32_GPIO6/SD_CLK: R44.1, R45.1, U5.31
/ESP32_GPIO7/SD_DATA0: U5.32, U7.2, U8.2
/ESP32_GPIO8/SD_DATA1: U5.33, U7.5, U8.5
/ESP32_GPIO9/SD_DATA2: U5.28, U7.7, U8.7
/ESP32_GPIO10/SD_DATA3: U5.29, U7.3, U8.3
/ESP32_GPIO11/SD_CMD: U5.30, U7.1
/ESP32_GPIO12/HS2_DATA2: MICRO_SD1.1, R30.2, U5.18
/ESP32_GPIO13/HS2_DATA3: MICRO_SD1.2, R27.2, U5.20
/ESP32_GPIO14/HS2_CLK: R38.1, U5.17
/ESP32_GPIO15/HS2_CMD: MICRO_SD1.3, R28.2, U5.21
/ESP32_GPIO16/PSRAM_CS#: R48.1, U5.25, U8.1
/ESP32_GPIO17/PSRAM_SCLK: R46.1, U5.27
/ESP32_GPIO21/VSPIHD: EXT2.6, U5.42
/ESP32_GPIO22/VSPIWP: EXT2.7, U5.39
/ESP32_GPIO25: EXT2.9, U5.14
/ESP32_GPIO26: EXT2.10, U5.15
/RA0: EXT1.11, U1.19
/RA1: EXT1.12, U1.20
/RA2/OSC1: C13.1, Q1.1, R14.1, U1.30
/RA3/OSC2: R15.1, U1.31
/RA4/SOSCO: R16.1, U1.34
/RA7: EXT1.13, U1.13
/RA8: EXT1.14, U1.32
/RA9: EXT1.15, U1.35
/RA10: EXT1.16, U1.12
/RB0/PGED1: EXT1.5, U1.21
/RB1/PGEC1: EXT1.6, U1.22
/RB2: EXT1.7, PROG_EN1.1, U1.23
/RB3: EXT1.8, U1.24
/RB4/SOSCI: C16.1, Q2.2, R17.1, U1.33
/RB5/USB-OTG_ID: U1.41, USB-OTG1.4
/RB7/USB-OTG_FAULT: R22.1, R23.1, U1.43
/RB8/SCL1(ESP32_GPIO27/I2C-SCL): EXT2.11, R42.2, U1.44, U5.16, U6.6
/RB9/SDA1(ESP32_GPIO32/I2C-SDA): EXT2.12, R43.2, U1.1, U5.12, U6.5
/RB10/USB-OTG_D+: U1.8, USB-OTG1.3
/RB11/USB-OTG_D-: U1.9, USB-OTG1.2
/RB13: EXT1.9, U1.11
/RB14/USB-OTG_EN(VBUSON): R31.2, U1.14, U4.4
/RB15/SCK2(ESP32_GPIO18/VSPICLK): EXT2.4, U1.15, U5.35
/RC0: EXT1.10, U1.25
/RC1/SDO2(ESP32_GPIO19/VSPIQ): EXT2.5, U1.26, U5.38
/RC2/~SS2~(ESP32_GPIO5/VSPICS0): EXT2.3, U1.27, U5.34
/RC3/SDI2(ESP32_GPIO23/VSPID): EXT2.8, U1.36, U5.36
/RC5/~DTR~(ESP32_PGM): R37.1, U1.38
/RC6/U1RXD(ESP32_PGM): R34.1, U1.2
/RC7/U1TXD(ESP32_PGM): R33.1, U1.3
/RC8/U2RX(ESP32_GPIO33/U2TXD): U1.4, U5.13
/RC9/U2TX(ESP32_GPI34/U2RXD): U1.5, U5.10
/STAT1: R7.2, U2.3
/STAT2: R5.2, U2.4
/~MCLR: C17.1, EXT1.2, R2.2, U1.18
GND: ANT1.2, BAT1.2, C1.2, C2.2, C3.2, C4.2, C5.2, C6.2, C7.2, C8.2, C9.2, C10.1, C11.1, C12.2, C13.2, C14.2, C15.2, C16.2, C18.2, C19.2, C20.2, C21.2, C22.2, C23.1, C24.2, C25.2, C26.2, C31.2, C32.2, C33.2, C34.2, C35.2, C36.2, C37.2, C38.2, C39.2, C40.1, C41.1, D2.2, EXT1.4, GND_Pin1.1, L3.2, L5.2, MICRO_SD1.6, MICRO_SD1.CH1, Q3.3, R3.2, R4.2, R6.2, R11.2, R19.2, R22.2, R24.1, R31.1, R32.2, U1.6, U1.16, U1.29, U1.39, U2.5, U3.2, U4.2, U5.49, U6.4, U7.4, U8.4, USB-OTG1.5
unnamed: ANT1.1, C23.2, C30.2
unnamed: BAT1.1, FET2.3, R13.1, U2.9, U2.10
unnamed: BUT1.2, R32.1
unnamed: C1.1, R1.1, R2.1
unnamed: C2.1, L1.2, U1.17
unnamed: C6.1, C7.1, U1.7
unnamed: C10.2, D3.1, FET2.2, R13.2, U3.1, U3.4
unnamed: C14.1, Q1.2, R14.2, R15.2
unnamed: C15.1, Q2.1, R16.2, R17.2
unnamed: C17.2, PROG_EN1.2, R35.1
unnamed: C19.1, C27.2, R25.1, U5.48
unnamed: C20.1, Q3.1, R26.1, U5.45
unnamed: C21.1, Q3.2, R26.2, U5.44
unnamed: C27.1, R25.2, U5.47
unnamed: C30.1, L5.1, U5.2
unnamed: C31.1, C34.1, L4.2, R23.2, U4.1
unnamed: C32.1, R20.2, R21.2, U5.9
unnamed: C38.1, L6.2, MICRO_SD1.4
unnamed: CHARGING1.1, R7.1
unnamed: COMPLETE1.1, R5.1
unnamed: L2.1, U3.3
unnamed: L3.1, USB-OTG1.0
unnamed: MICRO_SD1.5, R38.2
unnamed: MICRO_SD1.7, R39.2
unnamed: PWRLED1.1, R4.1
unnamed: PWR_GOOD1.1, R12.1
unnamed: R6.1, U2.6
unnamed: R8.1, R9.1, U1.42
unnamed: R10.1, U2.8
unnamed: R10.2, R11.1, THERM1.1
unnamed: R12.2, U2.7
unnamed: R18.1, R19.1, U3.5
unnamed: R24.2, U4.3
unnamed: R44.2, U7.6
unnamed: R45.2, R46.2, U8.6
