OLIMEX/ESP32-PRO/(commit log)

2017-06-21 ESP32-PRO schematic
2018-08-02 Update
    added rev B
    [ESP32-PRO_Rev_B-BOM.ods, ESP32-PRO_Rev_B.kicad_pcb, ESP32-PRO_Rev_B.sch]
2018-11-05 Update
    Arduino IDE demos
2020-09-01 Update
    revision B1 added
    [434121043836 (rev1).stp, BAT54.step, DO-214AA_SMB.step, DO-214AC_SMA.step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]
